mattpidden/radio-proximity-sensors/photos/IMG_0696.jpeg

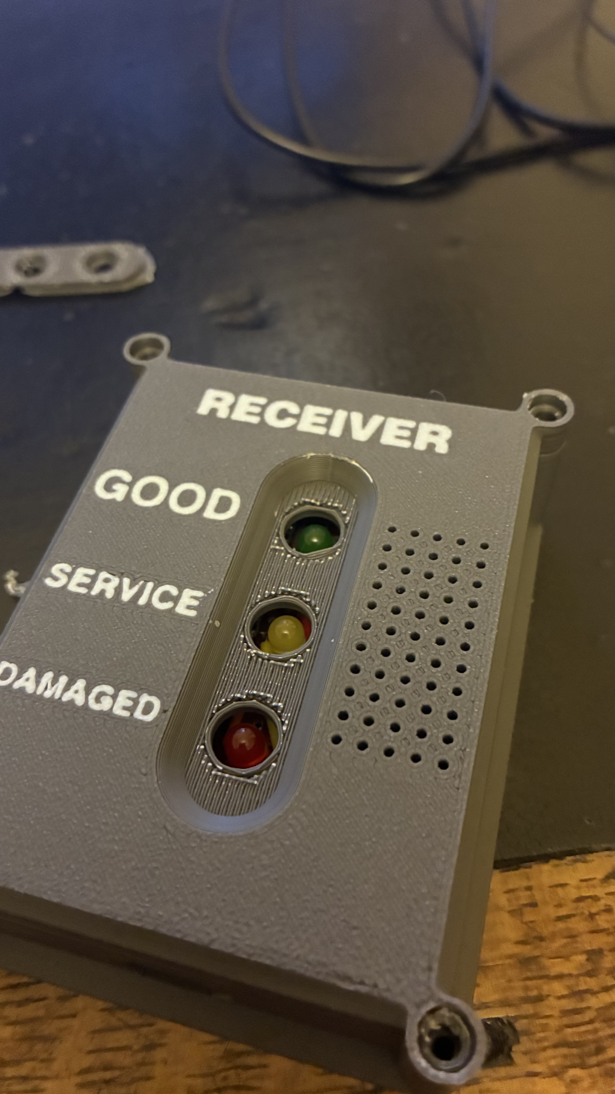
photos/IMG_0696.jpeg
