mattpidden/radio-proximity-sensors/transmitter/transmitter.ino

#include <RadioLib.h>
#include <SPI.h>

// --- LoRa Pin Definitions (Waveshare RP2040-LoRa-HF) ---
#define LORA_SCK     14
#define LORA_MISO    24
#define LORA_MOSI    15
#define LORA_SS      13
#define LORA_RST     23
#define LORA_DIO1    16
#define LORA_BUSY    18
#define LORA_ANT_SW  17 // Not used for this module instantiation

// --- Front Panel Pin Definitions ---
#define GREEN_LED     9
#define YELLOW_LED    6
#define RED_LED       3
#define YELLOW_BUTTON 5
#define RED_BUTTON    4

// Initialize the SX1262 module using SPI1 instance
SX1262 radio = new Module(LORA_SS, LORA_DIO1, LORA_RST, LORA_BUSY, SPI1);

// --- State Variables ---
// Flag to indicate transmission finished (set by interrupt)
volatile bool operationDone = false;
// Counter for unique packets
int packetCounter = 0;
// Transmission result state
int transmissionState = RADIOLIB_ERR_NONE;

// Non-blocking timer variables
unsigned long lastTxTime = 0;
const long txInterval = 10000; // Transmit every 10000 milliseconds (10 seconds)
const unsigned long holdThreshold = 1000; // 1 second hold
static unsigned long yellowPressTime = 0;
static unsigned long redPressTime = 0;
int lastYellowState = HIGH;
int lastRedState = HIGH;
static bool yellowHeld = false;
static bool redHeld = false;
enum Mode {
  GREEN,
  YELLOW,
  RED
};
Mode currentMode = GREEN;
String deviceId = "RACPIDDEN";

// --- Interrupt Handler ---
#if defined(ESP8266) || defined(ESP32)
  ICACHE_RAM_ATTR
#endif
void setFlag(void) {
  // We sent a packet, set the flag
  operationDone = true;
}

void setup() {
  Serial.begin(9600);
  delay(2000);

  // --- SPI Initialization ---
  SPI1.setRX(LORA_MISO);
  SPI1.setTX(LORA_MOSI);
  SPI1.setSCK(LORA_SCK);
  SPI1.begin();

  // --- Radio Initialization ---
  Serial.print(F("[TX] Initializing SX1262 ... "));
  // radio.begin(Freq, BW, SF, CR, SyncWord, Power, PreambleLen, AmplifierGain)
  int state = radio.begin(868.0, 125.0, 12, 5, RADIOLIB_SX126X_SYNC_WORD_PRIVATE, 17, 14, 0);

  if (state == RADIOLIB_ERR_NONE) {
    Serial.println(F("success!"));
  } else {
    Serial.print(F("failed, code "));
    Serial.println(state);
    while (true) { delay(10); }
  }

  // Set the function that will be called when packet is transmitted
  radio.setDio1Action(setFlag);
  pinMode(GREEN_LED, OUTPUT);
  pinMode(YELLOW_LED, OUTPUT);
  pinMode(RED_LED, OUTPUT);
  pinMode(YELLOW_BUTTON, INPUT_PULLUP);
  pinMode(RED_BUTTON, INPUT_PULLUP);
}

void updateLEDs(){
  switch (currentMode) {
    case GREEN:
      digitalWrite(GREEN_LED, HIGH);
      digitalWrite(YELLOW_LED, LOW);
      digitalWrite(RED_LED, LOW);
      break;

    case YELLOW:
      digitalWrite(GREEN_LED, LOW);
      digitalWrite(YELLOW_LED, HIGH);
      digitalWrite(RED_LED, LOW);
      break;

    case RED:
      digitalWrite(GREEN_LED, LOW);
      digitalWrite(YELLOW_LED, LOW);
      digitalWrite(RED_LED, HIGH);
      break;
  }
}

void loop() {
  updateLEDs();
  int currentYellowState = digitalRead(YELLOW_BUTTON);
  if (currentYellowState == LOW) {
    if (yellowPressTime == 0) yellowPressTime = millis();
    if (!yellowHeld && millis() - yellowPressTime > holdThreshold) {
      currentMode = GREEN;
      yellowHeld = true;
    }
  } else {
    if (yellowPressTime != 0 && !yellowHeld) currentMode = YELLOW;
    yellowPressTime = 0;
    yellowHeld = false;
  }

  int currentRedState = digitalRead(RED_BUTTON);
  if (currentRedState == LOW) {
    if (redPressTime == 0) redPressTime = millis();
    if (!redHeld && millis() - redPressTime > holdThreshold) {
      currentMode = GREEN;
      redHeld = true;
    }
  } else {
    if (redPressTime != 0 && !redHeld) currentMode = RED;
    redPressTime = 0;
    redHeld = false;
  }

  // 1. Check if the previous transmission finished
  if(operationDone) {
    // reset flag
    operationDone = false;

    // Report on the status of the last transmission
    if (transmissionState == RADIOLIB_ERR_NONE) {
      Serial.println(F(" Transmission finished successfully."));
    } else {
      Serial.print(F(" Transmission failed, code "));
      Serial.println(transmissionState);
    }
  }

  // 2. Check if it's time to send a new packet
  if(millis() - lastTxTime >= txInterval) {
    // Generate the payload
    packetCounter++;
    String payload = deviceId;
    if (currentMode == GREEN) {
      payload += "-G1";
    }
    if (currentMode == YELLOW) {
      payload += "-Y1";
    }
    if (currentMode == RED) {
      payload += "-R1";
    }

    Serial.print(F("[TX] Sending packet #"));
    Serial.print(packetCounter);
    Serial.print(F(" ("));
    Serial.print(payload);
    Serial.print(F(") ..."));

    // Start the asynchronous transmission
    transmissionState = radio.startTransmit(payload);

    // Update timer
    lastTxTime = millis();
  }
}
